humanHardDrive/Arduino_Thermostat/RemoteSensor/Layout/Output/RemoteSensor.pdf

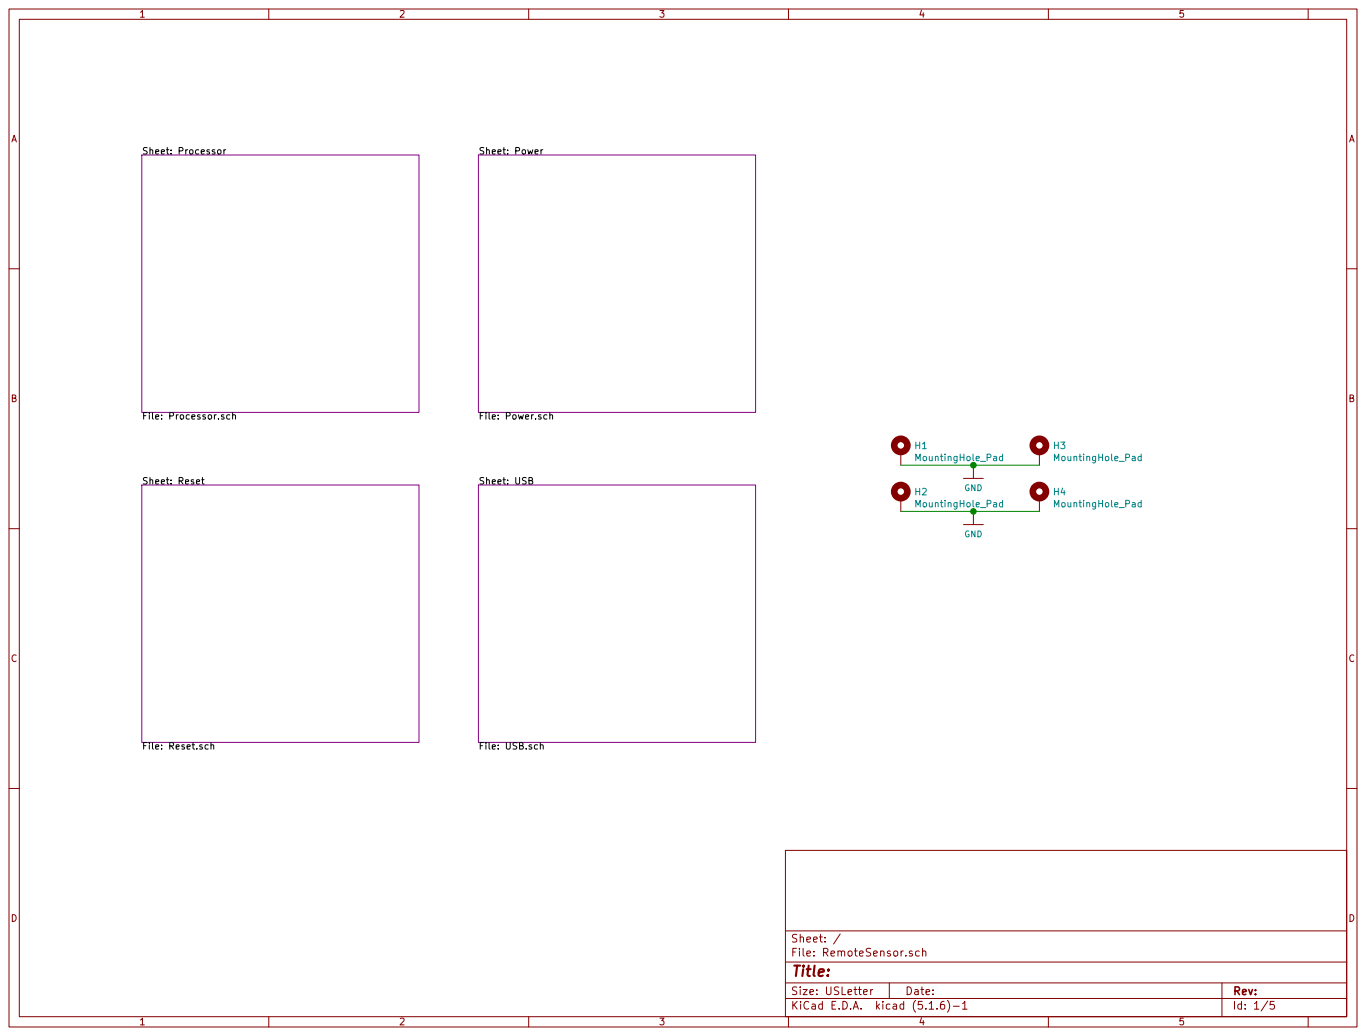
[picture p1: page 1]

Sheet: Power File: Power.sch Sheet: Reset File: Reset.sch

Id: 1/5 Title: File: RemoteSensor.sch Sheet: /

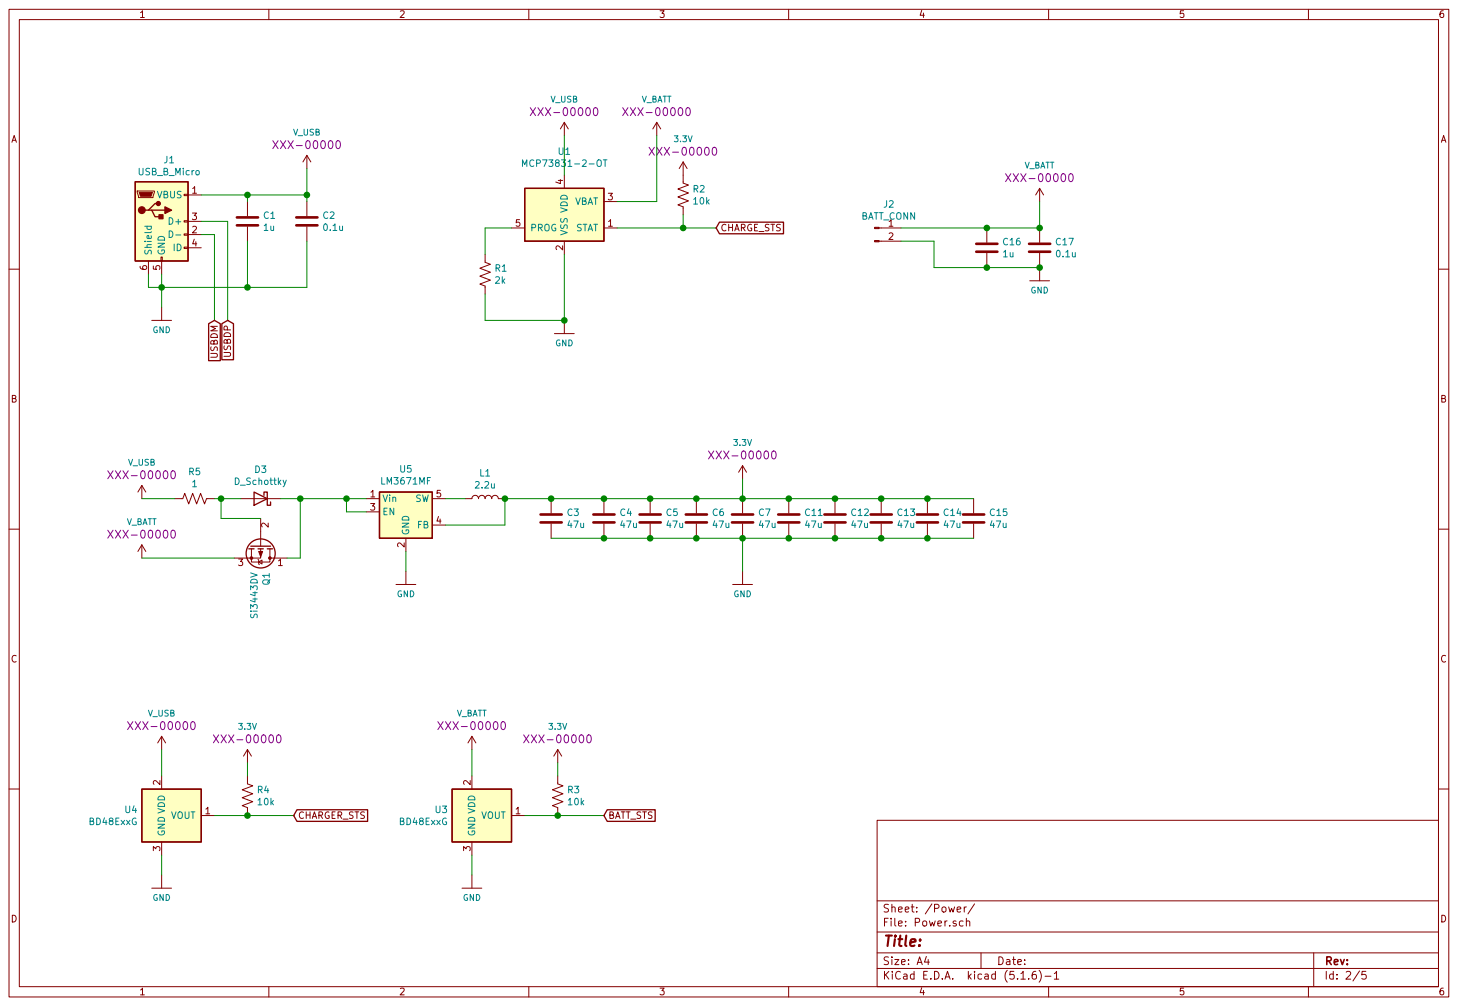
[picture p2: page 2]

Id: 2/5 Title: File: Power.sch Sheet: /Power/ GND

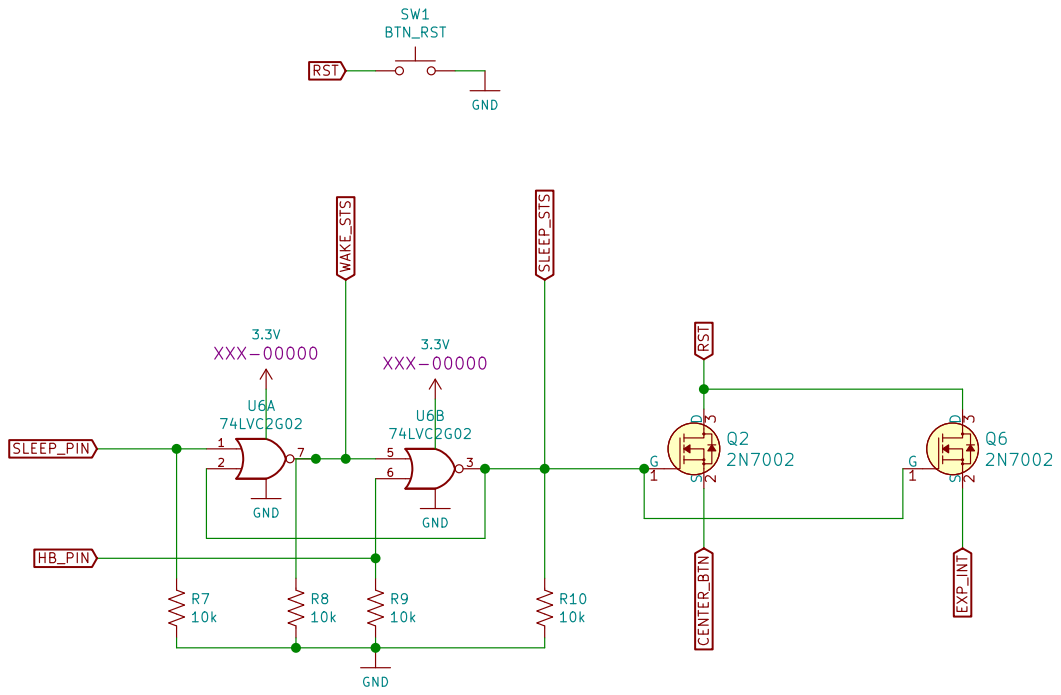
[picture p3: page 3]

Id: 3/5 Title: File: Reset.sch Sheet: /Reset/ R7

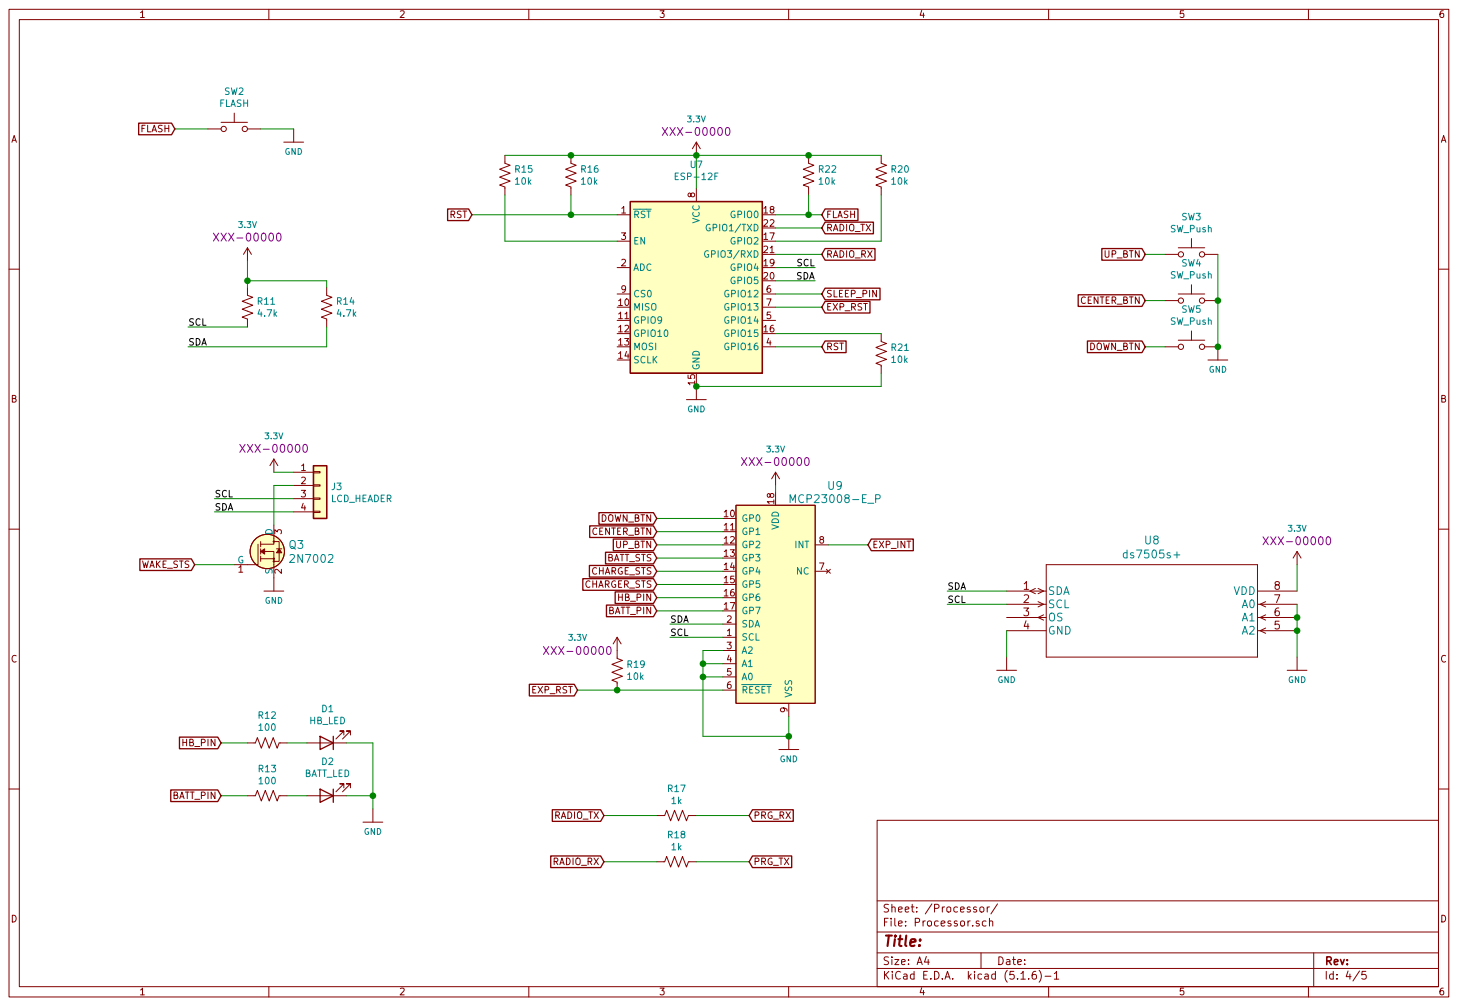
[picture p4: page 4]

Id: 4/5 Title: File: Processor.sch Sheet: /Processor/

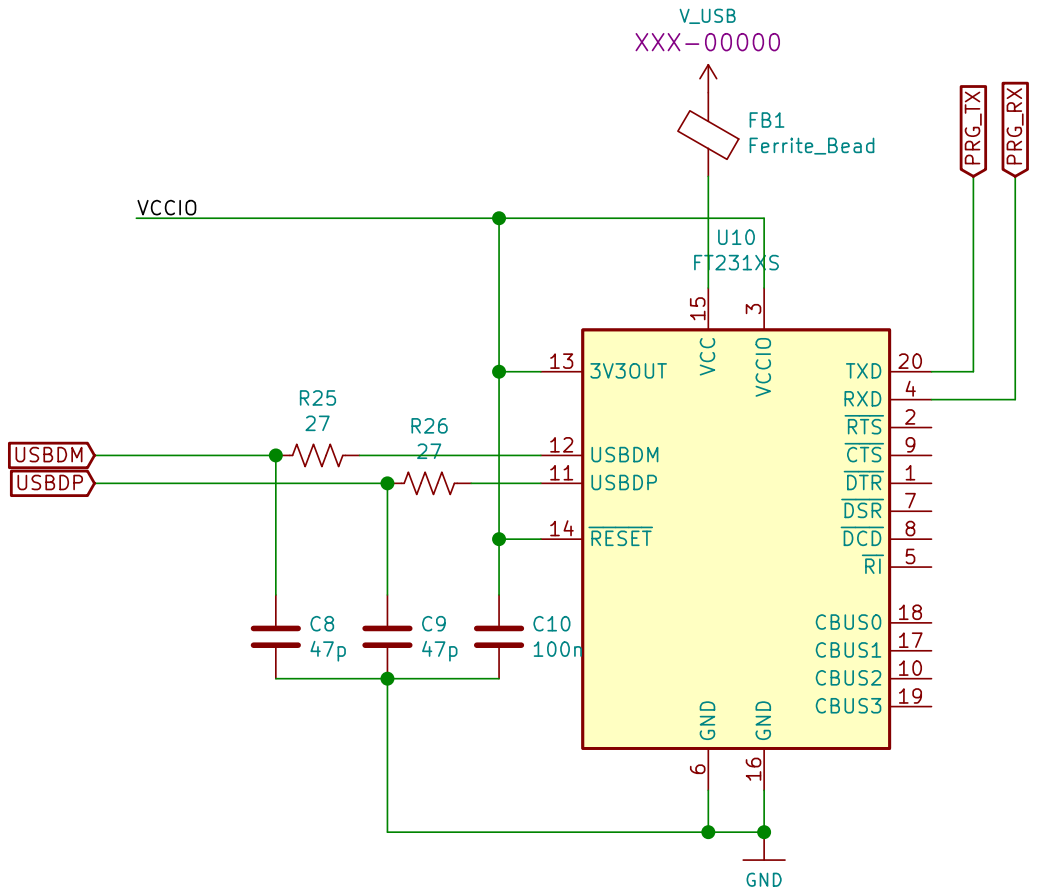
[picture p5: page 5]

Id: 5/5 Title: File: USB.sch Sheet: /USB/
