humanHardDrive/Arduino_Thermostat/(list of files, drawings)

Other design files:
Button_Board/Button_Board.dsn
RemoteSensor/Layout/Output/RemoteSensor.dsn
