humanHardDrive/Arduino_Thermostat/RemoteSensor/Layout/RemoteSensor.kicad_pcb

## KiCad design RemoteSensor/Layout/RemoteSensor.kicad_pcb (2020-09-29)

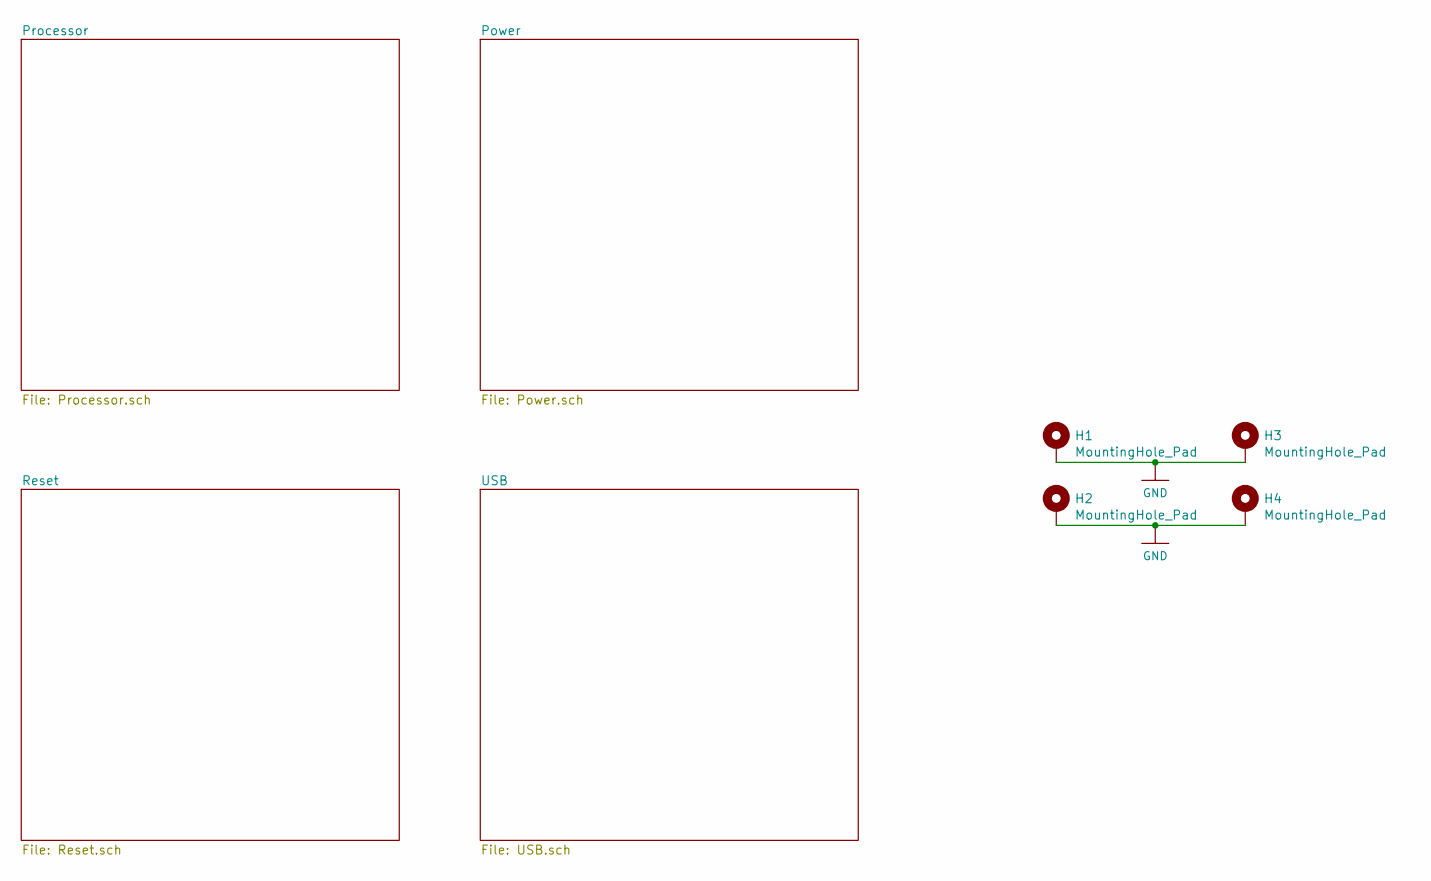
[picture p6: schematic RemoteSensor.sch]

Parts:
H1, H2, H3, H4: MountingHole_Pad; MountingHole_2.7mm_M2.5_DIN965_Pad

Connections:
GND: H1.1, H2.1, H3.1, H4.1; also elsewhere on the board

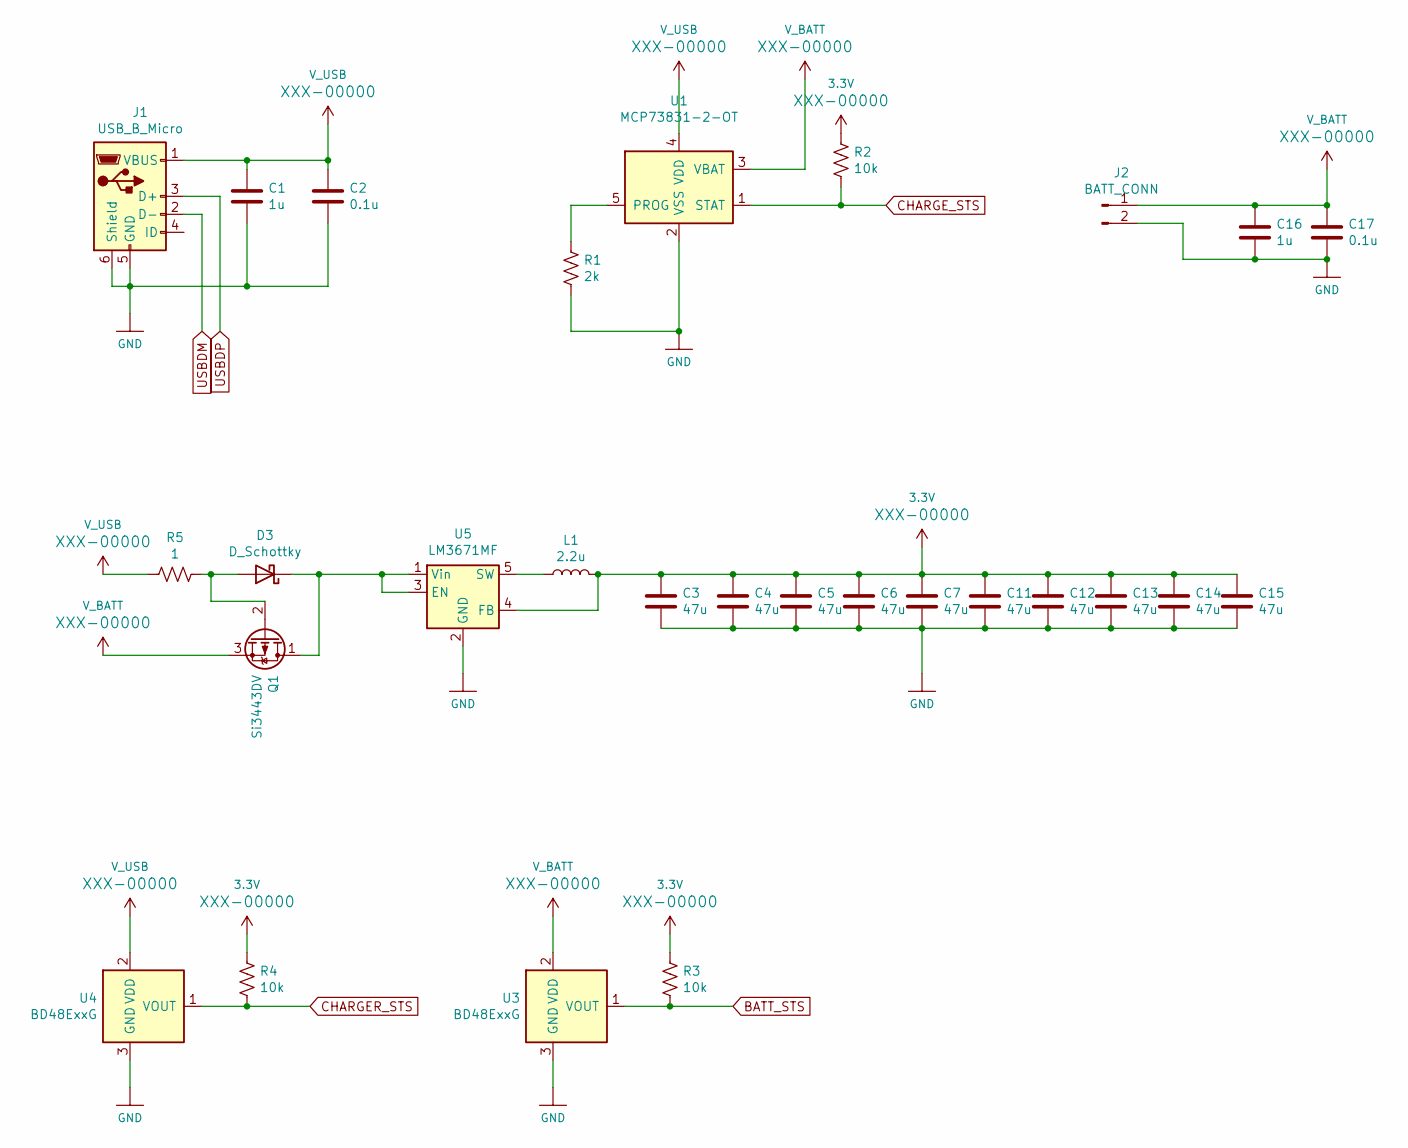
[picture p7: schematic Power.sch]

Parts:
C1, C16: 1u; C_0603_1608Metric_Pad1.05x0.95mm_HandSolder
C2, C17: 0.1u; C_0603_1608Metric_Pad1.05x0.95mm_HandSolder
C3, C4, C5, C6, C7, C11, C12, C13, C14, C15: 47u; C_0603_1608Metric_Pad1.05x0.95mm_HandSolder
D3: D_Schottky; D_SOD-123
J1: USB_B_Micro; USB_Micro-B_Molex_47346-0001
J2: BATT_CONN; JST_PH_S2B-PH-SM4-TB_1x02-1MP_P2.00mm_Horizontal
L1: 2.2u; L_Taiyo-Yuden_NR-30xx_HandSoldering
Q1: Si3443DV
R1: 2k; R_0603_1608Metric_Pad1.05x0.95mm_HandSolder
R2, R3, R4: 10k; R_0603_1608Metric_Pad1.05x0.95mm_HandSolder
R5: 1; R_0603_1608Metric_Pad1.05x0.95mm_HandSolder
U1: MCP73831-2-OT; SOT-23-5
U3, U4: BD48ExxG; SOT-23-5
U5: LM3671MF; TSOT-23-5

Connections:
3.3V: C3.1, C4.1, C5.1, C6.1, C7.1, C11.1, C12.1, C13.1, C14.1, C15.1, L1.2, R2.1, R3.1, R4.1, U5.4 (FB); also elsewhere on the board
BATT_STS: R3.2, U3.1 (VOUT); also elsewhere on the board
CHARGER_STS: R4.2, U4.1 (VOUT); also elsewhere on the board
CHARGE_STS: R2.2, U1.1 (STAT); also elsewhere on the board
GND: C1.2, C2.2, C3.2, C4.2, C5.2, C6.2, C7.2, C11.2, C12.2, C13.2, C14.2, C15.2, C16.2, C17.2, J1.5 (GND), J1.6 (Shield), J2.2, R1.2, U1.2 (VSS), U3.3 (GND), U4.3 (GND), U5.2 (GND); also elsewhere on the board
unnamed: D3.1 (K), Q1.1 (D), U5.1 (Vin), U5.3 (EN)
unnamed: D3.2 (A), Q1.2 (G), R5.1
unnamed: L1.1, U5.5 (SW)
unnamed: R1.1, U1.5 (PROG)
USBDM: J1.2 (D-); also elsewhere on the board
USBDP: J1.3 (D+); also elsewhere on the board
V_BATT: C16.1, C17.1, J2.1, Q1.3 (S), U1.3 (VBAT), U3.2 (VDD)
V_USB: C1.1, C2.1, J1.1 (VBUS), R5.2, U1.4 (VDD), U4.2 (VDD); also elsewhere on the board

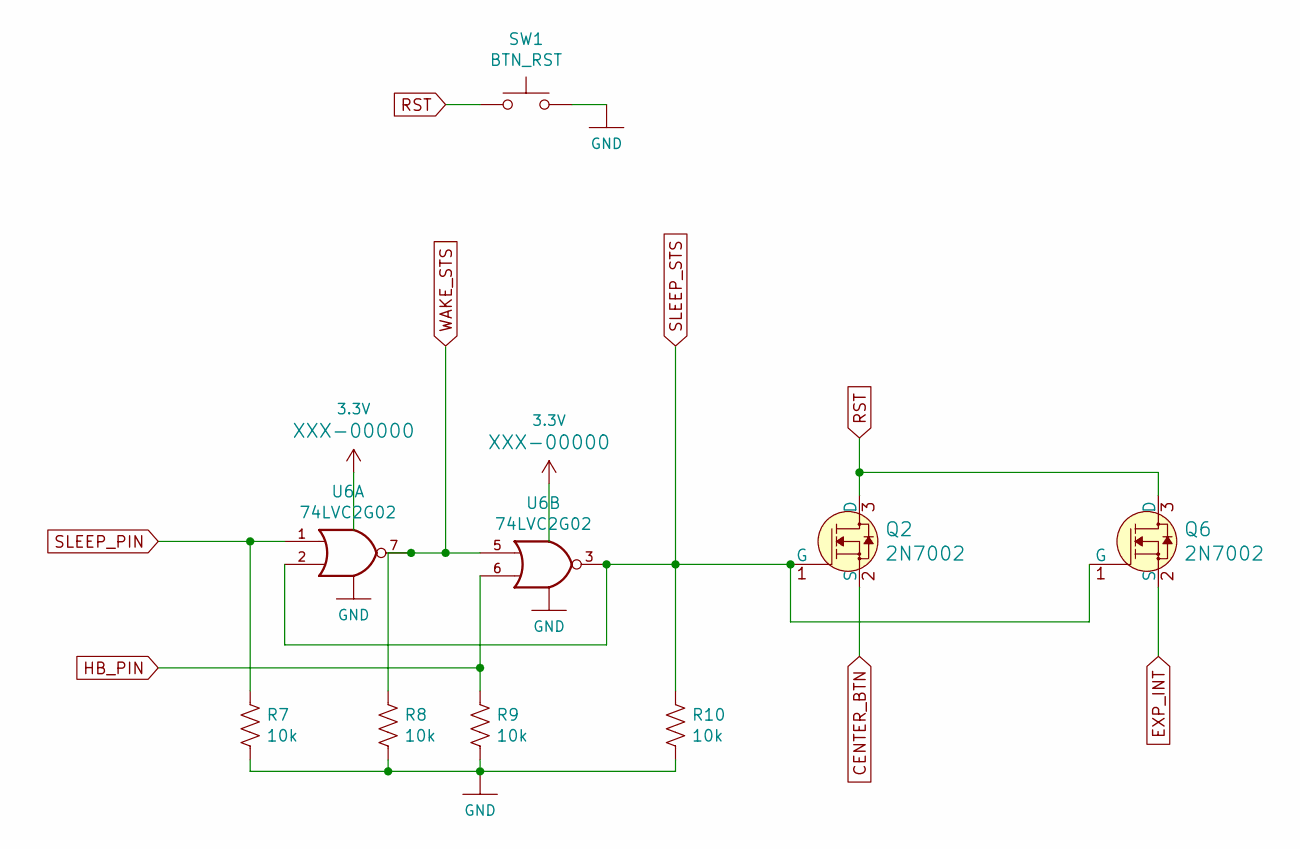
[picture p8: schematic Reset.sch]

Parts:
Q2, Q6: 2N7002; SOT-23-3; MPN 2N7002; Digi-Key_PN 2N7002NCT-ND
R7, R8, R9, R10: 10k; R_0603_1608Metric_Pad1.05x0.95mm_HandSolder
SW1: BTN_RST; SW_SPST_TL3342
U6: 74LVC2G02; VSSOP-8_2.3x2mm_P0.5mm

Connections:
3.3V: U6.8 (VCC); also elsewhere on the board
CENTER_BTN: Q2.2 (S); also elsewhere on the board
EXP_INT: Q6.2 (S); also elsewhere on the board
GND: R7.2, R8.2, R9.2, R10.2, SW1.2, U6.4 (GND); also elsewhere on the board
HB_PIN: R9.1, U6.6; also elsewhere on the board
RST: Q2.3 (D), Q6.3 (D), SW1.1; also elsewhere on the board
SLEEP_PIN: R7.1, U6.1; also elsewhere on the board
SLEEP_STS: Q2.1 (G), Q6.1 (G), R10.1, U6.2, U6.3
WAKE_STS: R8.1, U6.5, U6.7; also elsewhere on the board

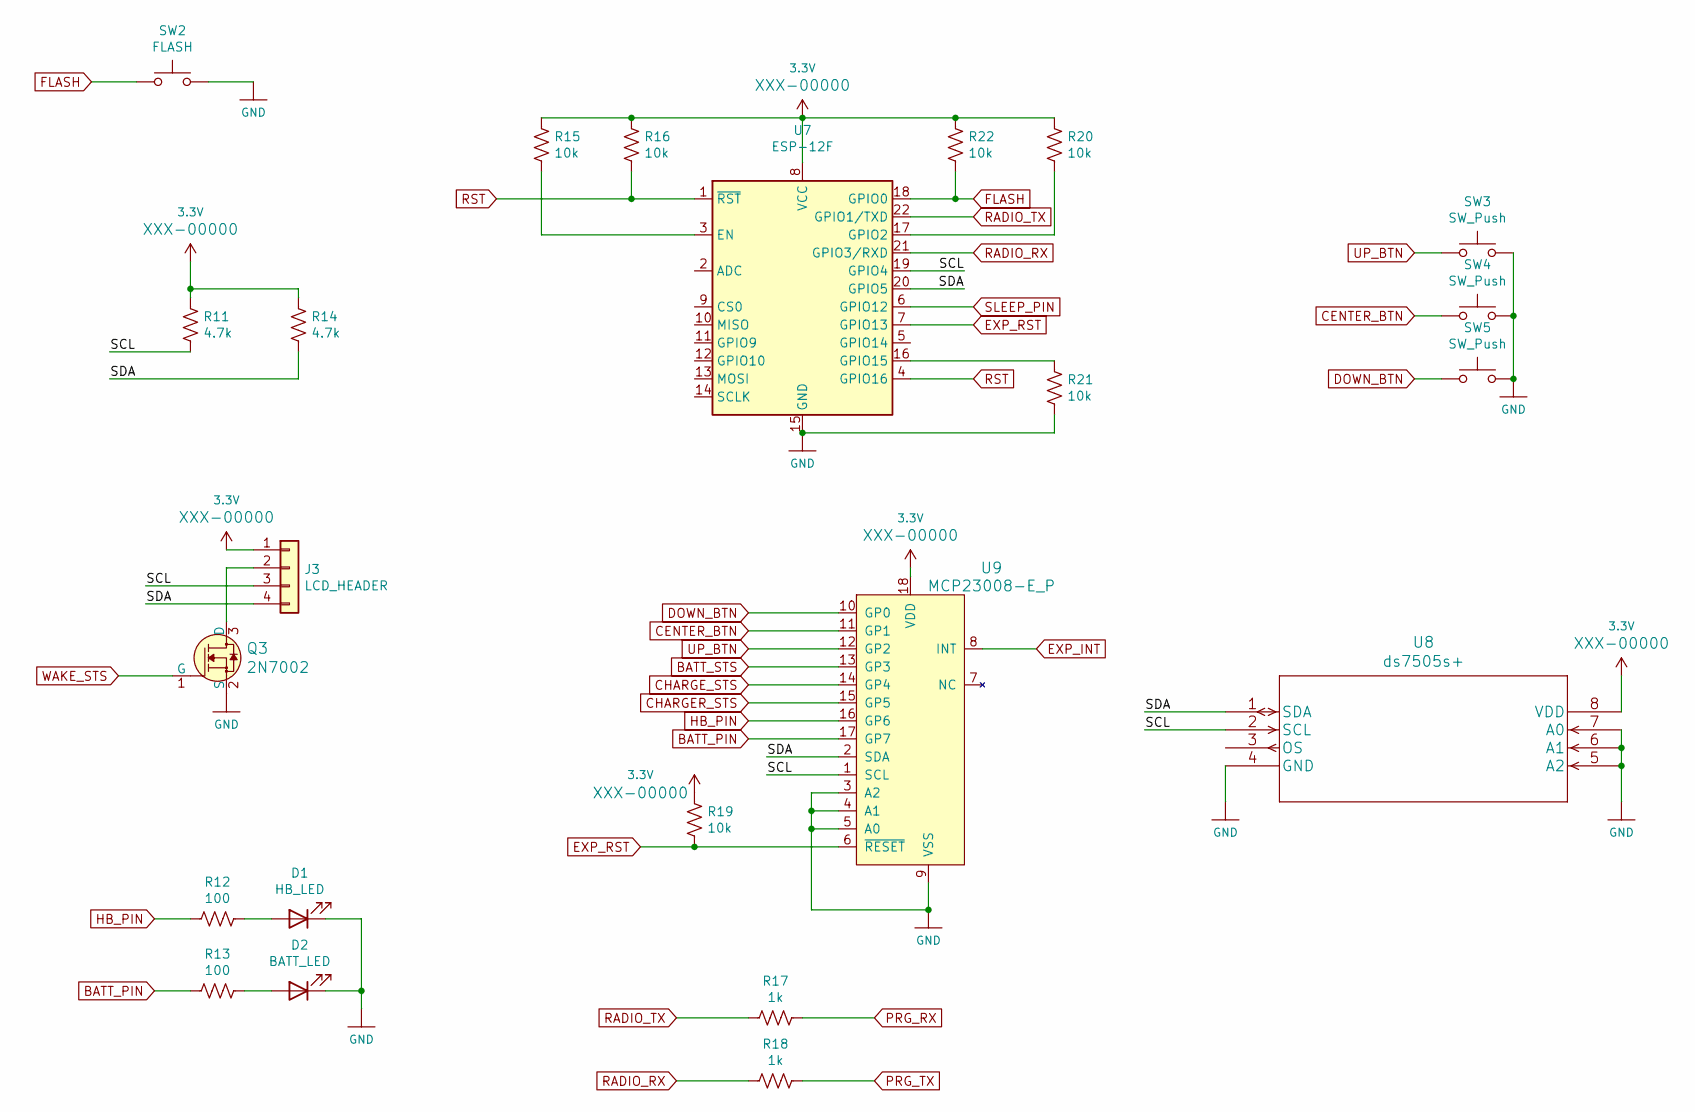
[picture p9: schematic Processor.sch]

Parts:
D1: HB_LED; LED_0603_1608Metric_Pad1.05x0.95mm_HandSolder
D2: BATT_LED; LED_0603_1608Metric_Pad1.05x0.95mm_HandSolder
J3: LCD_HEADER; PinSocket_1x04_P2.54mm_Vertical
Q3: 2N7002; SOT-23-3; MPN 2N7002; Digi-Key_PN 2N7002NCT-ND
R11, R14: 4.7k; R_0603_1608Metric_Pad1.05x0.95mm_HandSolder
R12, R13: 100; R_0603_1608Metric_Pad1.05x0.95mm_HandSolder
R15, R16, R19, R20, R21, R22: 10k; R_0603_1608Metric_Pad1.05x0.95mm_HandSolder
R17, R18: 1k; R_0603_1608Metric_Pad1.05x0.95mm_HandSolder
SW2: FLASH; SW_SPST_TL3342
SW3, SW4, SW5: SW_Push; KSS331GLFS
U7: ESP-12F; ESP-12E
U8: ds7505s+; SOIC-8_3.9x4.9mm_P1.27mm
U9: MCP23008-E_P; SOIC-18W_7.5x11.6mm_P1.27mm; MPN MCP23008-E/P; Digi-Key_PN MCP23008-E/P-ND

Connections:
3.3V: J3.1, R11.1, R14.1, R15.1, R16.1, R19.1, R20.1, R22.1, U7.8 (VCC), U8.8 (VDD), U9.18 (VDD); also elsewhere on the board
/Processor/SCL: J3.3, R11.2, U7.19 (GPIO4), U8.2 (SCL), U9.1 (SCL)
/Processor/SDA: J3.4, R14.2, U7.20 (GPIO5), U8.1 (SDA), U9.2 (SDA)
BATT_PIN: R13.2, U9.17 (GP7)
BATT_STS: U9.13 (GP3); also elsewhere on the board
CENTER_BTN: SW4.1, U9.11 (GP1); also elsewhere on the board
CHARGER_STS: U9.15 (GP5); also elsewhere on the board
CHARGE_STS: U9.14 (GP4); also elsewhere on the board
DOWN_BTN: SW5.1, U9.10 (GP0)
EXP_INT: U9.8 (INT); also elsewhere on the board
EXP_RST: R19.2, U7.7 (GPIO13), U9.6 (~RESET)
FLASH: R22.2, SW2.1, U7.18 (GPIO0)
GND: D1.1 (K), D2.1 (K), Q3.2 (S), R21.2, SW2.2, SW3.2, SW4.2, SW5.2, U7.15 (GND), U8.4 (GND), U8.5 (A2), U8.6 (A1), U8.7 (A0), U9.3 (A2), U9.4 (A1), U9.5 (A0), U9.9 (VSS); also elsewhere on the board
HB_PIN: R12.1, U9.16 (GP6); also elsewhere on the board
unnamed: D1.2 (A), R12.2
unnamed: D2.2 (A), R13.1
unnamed: J3.2, Q3.3 (D)
unnamed: R15.2, U7.3 (EN)
unnamed: R20.2, U7.17 (GPIO2)
unnamed: R21.1, U7.16 (GPIO15)
PRG_RX: R17.1; also elsewhere on the board
PRG_TX: R18.1; also elsewhere on the board
RADIO_RX: R18.2, U7.21 (GPIO3/RXD)
RADIO_TX: R17.2, U7.22 (GPIO1/TXD)
RST: R16.2, U7.1 (~RST), U7.4 (GPIO16); also elsewhere on the board
SLEEP_PIN: U7.6 (GPIO12); also elsewhere on the board
UP_BTN: SW3.1, U9.12 (GP2)
WAKE_STS: Q3.1 (G); also elsewhere on the board

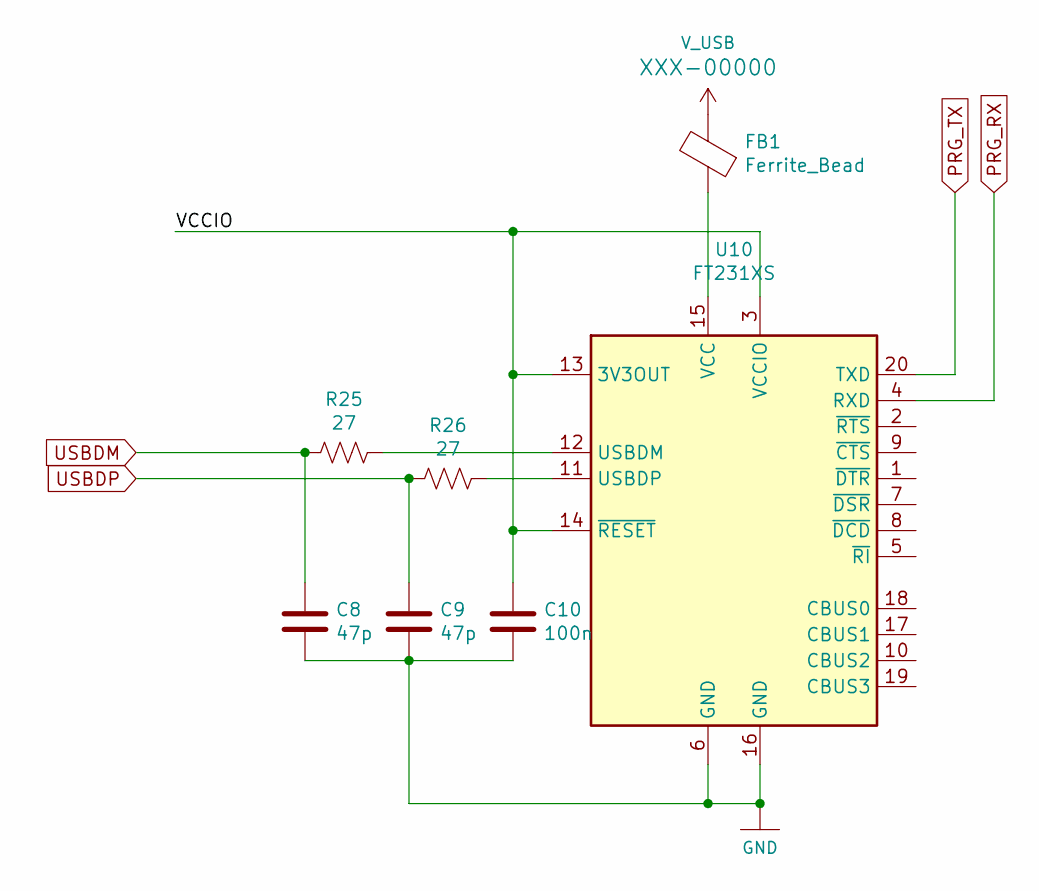
[picture p10: schematic USB.sch]

Parts:
C8, C9: 47p; C_0603_1608Metric_Pad1.05x0.95mm_HandSolder
C10: 100n; C_0603_1608Metric_Pad1.05x0.95mm_HandSolder
FB1: Ferrite_Bead; R_0603_1608Metric_Pad1.05x0.95mm_HandSolder
R25, R26: 27; R_0603_1608Metric_Pad1.05x0.95mm_HandSolder
U10: FT231XS; SSOP-20_3.9x8.7mm_P0.635mm

Connections:
/USB/VCCIO: C10.1, U10.3 (VCCIO), U10.13 (3V3OUT), U10.14 (~RESET)
GND: C8.2, C9.2, C10.2, U10.6 (GND), U10.16 (GND); also elsewhere on the board
unnamed: FB1.1, U10.15 (VCC)
unnamed: R25.1, U10.12 (USBDM)
unnamed: R26.1, U10.11 (USBDP)
PRG_RX: U10.4 (RXD); also elsewhere on the board
PRG_TX: U10.20 (TXD); also elsewhere on the board
USBDM: C8.1, R25.2; also elsewhere on the board
USBDP: C9.1, R26.2; also elsewhere on the board
V_USB: FB1.2; also elsewhere on the board

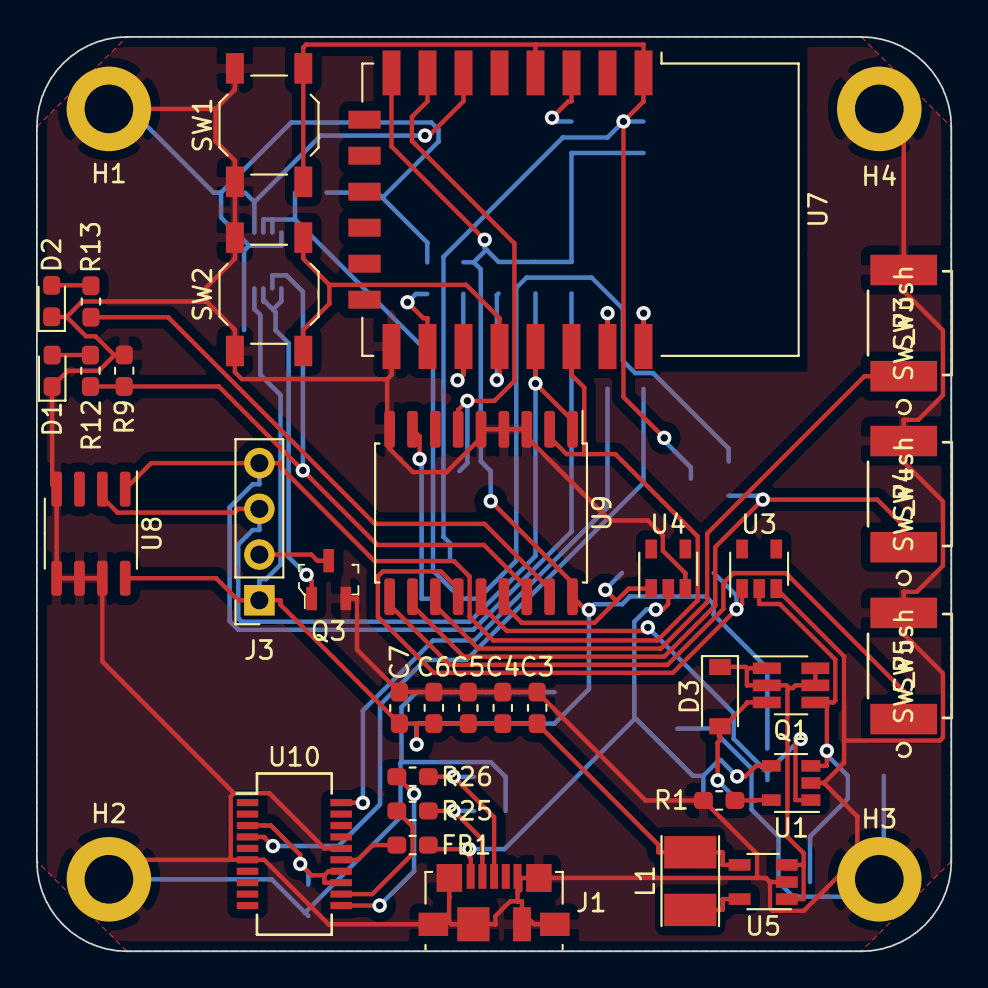
[picture p11: board RemoteSensor.kicad_pcb from above]

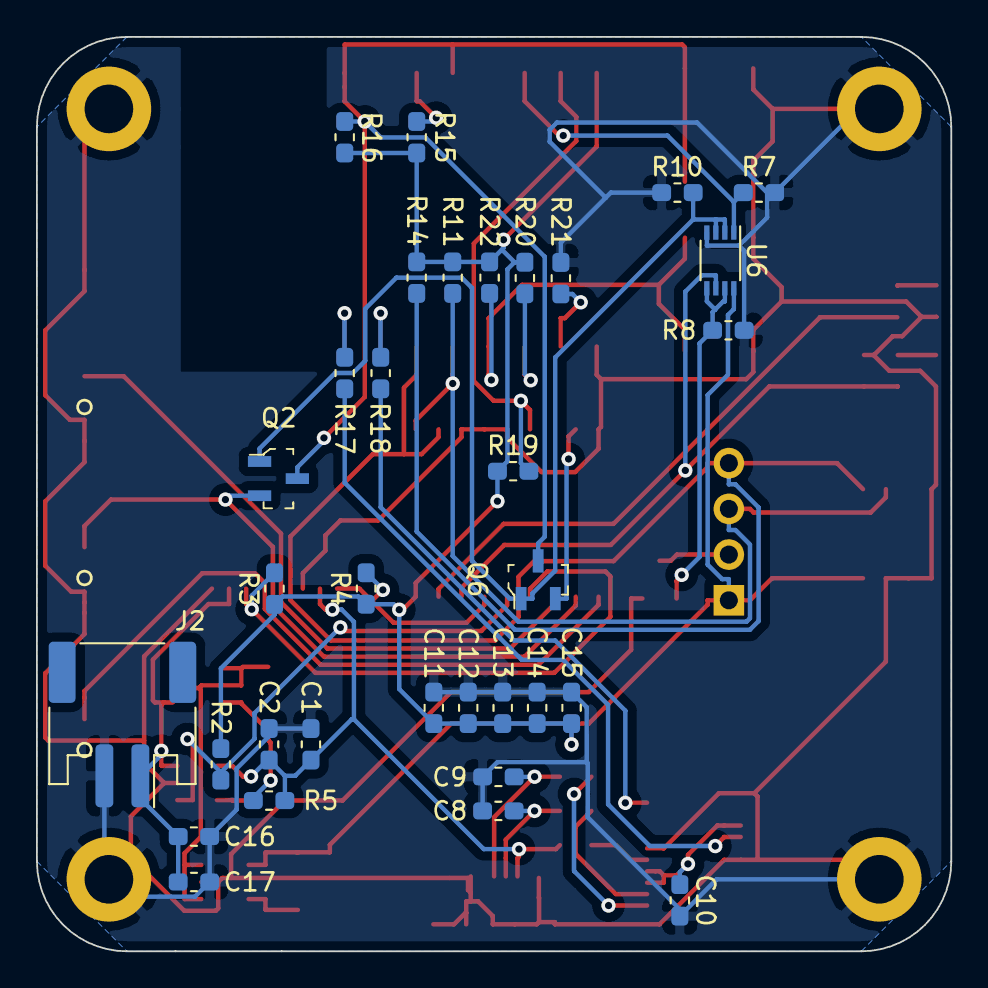
[picture p12: board RemoteSensor.kicad_pcb from below]

Board: 2 copper layers, 50.8 x 50.8 mm, 70 parts (33 on the bottom side), 41 nets.
