humanHardDrive/Arduino_Thermostat/Button_Board/Button_Board.kicad_pcb

## KiCad design Button_Board/Button_Board.kicad_pcb (2019-10-31)

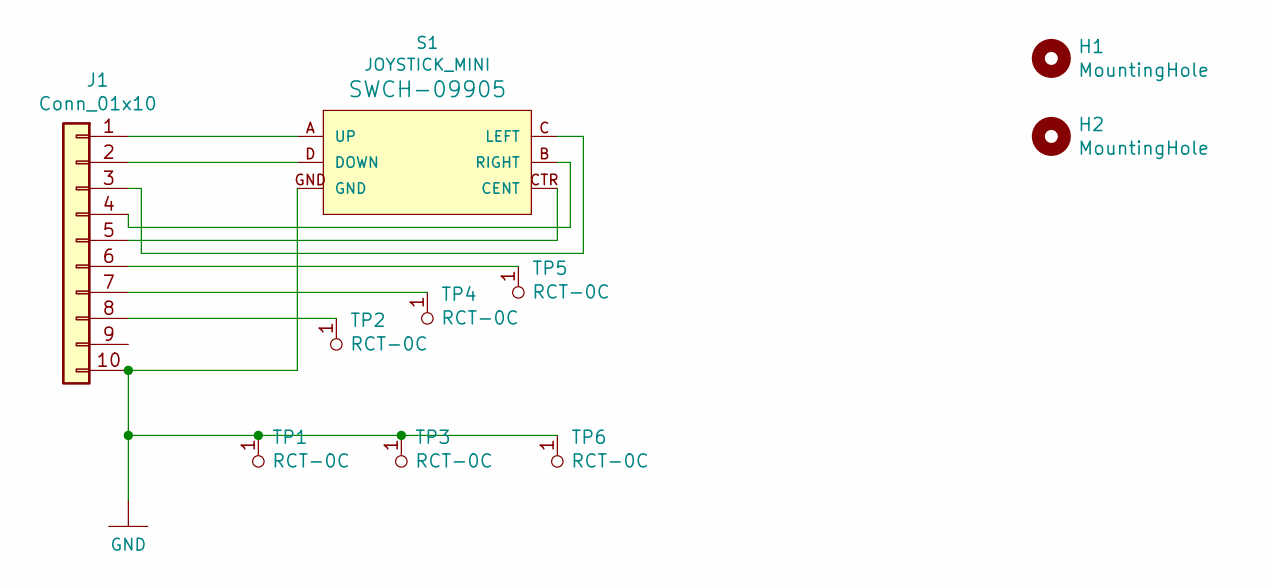
[picture p13: schematic Button_Board.sch]

Parts:
H1, H2: MountingHole; MountingHole_2.2mm_M2_ISO7380_Pad
J1: Conn_01x10; JST_PH_B10B-PH-SM4-TB_1x10-1MP_P2.00mm_Vertical
S1: JOYSTICK_MINI
TP1, TP2, TP3, TP4, TP5, TP6: RCT-0C; PROBE_PAD_0805; MPN RCT-0C; Digi-Key_PN A106144CT-ND

Connections:
GND: J1.10, S1.GND, TP1.1, TP3.1, TP6.1
unnamed: J1.1, S1.A (UP)
unnamed: J1.2, S1.D (DOWN)
unnamed: J1.3, S1.C (LEFT)
unnamed: J1.4, S1.B (RIGHT)
unnamed: J1.5, S1.CTR (CENT)
unnamed: J1.6, TP5.1
unnamed: J1.7, TP4.1
unnamed: J1.8, TP2.1

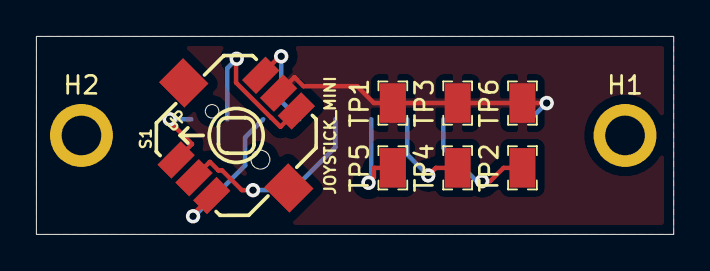
[picture p14: board Button_Board.kicad_pcb from above]

Board: 2 copper layers, 35.4 x 11.0 mm, 10 parts (1 on the bottom side), 9 nets.
