humanHardDrive/Arduino_Thermostat/Thermostat/Thermostat.ino

#include <Wire.h>
#include <DS3231.h>
#include <LiquidCrystal.h>
#include <Sleep_n0m1.h>
#include <Streaming.h>

#include "ThermostatDevice.h"
#include "SensorDevice.h"
#include "ESPInterface.h"

#define APP_NAME    F("REMOTE THERMOSTAT")
#define VERSION_MAJOR   0
#define VERSION_MINOR   0

/*Basic logging macro*/
#define LOG Serial << "\n\r" << millis() << '\t' << __FUNCTION__ << '\t'

//Arduino Pins
#define IO_EXP_RST_PIN  13
#define ESP_RST_PIN     12
#define ESP_EN_PIN      11
#define ESP_ST_PIN      10
#define LCD_RS_PIN      9
#define LCD_EN_PIN      8
#define LCD_D4_PIN      7
#define LCD_D5_PIN      6
#define LCD_D6_PIN      5
#define LCD_D7_PIN      4
#define HEARTBEAT_PIN   3
#define IO_EXP_INT_PIN  2

#define BATT_MON_EN_PIN A0
#define DBG_TX_PIN      A1
#define DBG_RX_PIN      A2
#define I2C_SDA         A4
#define I2C_SCL         A5
#define LOCAL_TEMP_PIN  A6
#define BATT_MON_PIN    A7

struct SaveInfo
{
  APInfo apInfo;
  ServerInfo serverInfo;

  uint16_t checksum;
};

SaveInfo saveInfo;

ESPInterface      espInterface;
SensorDevice      sensorDevice(LOCAL_TEMP_PIN, 1000, 1000);
ThermostatDevice  thermostatDevice(espInterface);

DS3231 Clock;
RTClib RTC;

bool bNeedRealTime = true;
uint32_t nLastTimePoll = 0;

char* sPubAliasList[] =
{
  "CurrentTemp",
  "CurrentMode",
  "" /*The empty string is the end of the array*/
};

char* sSubAliasList[] =
{
  "TargetTemp",
  "TargetMode",
  ""
};

bool waitForESPResponse(uint8_t cmd, void* outBuf, uint8_t outLen, void** inBuf, uint32_t timeout)
{
  bool bMsgReady = false;
  uint32_t nStartTime;
  uint8_t inCmd;

  espInterface.sendCommand(cmd, outBuf, outLen);
  delay(1);
  nStartTime = millis();

  while ((millis() - nStartTime) < timeout && !bMsgReady)
  {
    if (Serial.available())
    {
      espInterface.background(Serial.read());
      bMsgReady = espInterface.messageReady(&inCmd, inBuf);

      /*Continue processing messages while waiting for the response*/
      if (bMsgReady)
      {
        if (inCmd != cmd)
        {
          LOG << F("Unexpected response for cmd type ") << inCmd;
          bMsgReady = false;
        }
        /*Reset timer*/
        nStartTime = millis();
      }
    }
  }

  if (!bMsgReady)
  {
    LOG << F("No message returned");
    return false;
  }

  return true;
}

bool InitESPInterface()
{
  uint8_t *buf;

  LOG << F("Resetting ESP interface");
  digitalWrite(ESP_RST_PIN, LOW);
  delay(1);
  digitalWrite(ESP_RST_PIN, HIGH);

  /*Wait at most 10 seconds for the interface to show ready status*/
  uint32_t nStatusStartTime = millis();
  while ((millis() - nStatusStartTime) < 10000 &&
         digitalRead(ESP_ST_PIN))
  {
  }

  if (digitalRead(ESP_ST_PIN))
  {
    LOG << F("Interface didn't show ready status in time");
    return false;
  }

  return true;
}

void RecoverInfo()
{
  memset(&saveInfo, 0, sizeof(SaveInfo));

  thermostatDevice.setOffset(sizeof(SaveInfo));
  thermostatDevice.recover();
}

bool InitIOExpander()
{
  return false;
}

bool InitRTC()
{
  DateTime then = RTC.now();
  delay(1500);

  if (RTC.now().unixtime() == then.unixtime())
  {
    LOG << F("Failed to see clock change");
    return false;
  }

  LOG << F("Date ") << then.day() << '/' << then.month() << '/' << then.year();
  LOG << F("Time ") << then.hour() << ':' << then.minute();

  return true;
}

void setup()
{
  /*Setup serial*/
  Serial.begin(57600);
  Wire.begin();

  /*Setup pin directions*/
  pinMode(ESP_RST_PIN, OUTPUT);
  pinMode(ESP_ST_PIN, INPUT_PULLUP);

  /*Initialize components*/
  if (!InitESPInterface())
  {
    LOG << F("Failed to init ESP interface");
    while (1);
  }

  if (!InitRTC())
  {
    LOG << F("Failed to init RTC");
    while (1);
  }
}

void loop()
{
  if (bNeedRealTime && (millis() - nLastTimePoll) > 30000)
  {
    uint32_t* pCurrentTime;
    if (waitForESPResponse(TIME, NULL, 0, &pCurrentTime, 10))
    {
      if (*pCurrentTime)
      {
        LOG << F("Got current time");
        bNeedRealTime = false;
      }
      else
        LOG << F("ESP isn't connected to internet. Can't get time");
    }

    nLastTimePoll = millis();
    if (bNeedRealTime)
      LOG << F("Couldn't get time from ESP interface");
  }
}
