humanHardDrive/Arduino_Thermostat/Thermostat/ThermostatDevice.cpp

#include "ThermostatDevice.h"

ThermostatDevice::ThermostatDevice(MemDevice& memDevice) :
  m_MemDevice(memDevice)
{
  
}

void ThermostatDevice::update(DAY_OF_WEEK day, uint8_t nHour, uint8_t nMinute)
{
  
}
