humanHardDrive/Arduino_Thermostat/(commit log)

2019-04-10 Add temperature sensor project. Other changes.
2019-04-13 Put interface buttons on the IO expander
2019-04-14 Add modes for fan control and heat
2019-04-18 Add RTC library
    Use the RTC to set the target temperature based on a timed rule set.
2019-04-29 Start setting up the remote temperature sensor.
2019-04-30 Setup more of the thermostat's communication
    Handle entering and exiting discovery mode. Added some debug serial commands to interface without buttons.
2019-05-07 First successful recieve and trasmit
    Need to get the discovery pipe working properly and parse the message on the sensor side.
2019-05-11 Remove old code. Verify new functionality.
    The discovery message now only acts as a discovery, not discovery and pair. The remote device returns a name to be identified.
2019-05-11 Handle device discovery.
    List out all of the discovered devices
2019-05-19 Setup messages on the sensor to send temperature reading
2019-05-19 Start setting up handlers for temperature messages
    Started adding hooks to retry messages.
2019-05-19 Handle messages on the temperature sensor
2019-05-21 Add method to add paired device to saved list
2019-05-22 Add paired device to saved data list
2019-05-22 Only handle messages from paired devices
2019-05-23 Add function to rename paired devices
2019-05-24 Initialize temperature rules structure before overwritten by flash
2019-05-25 Add button debounce to IO expander
2019-05-25 Print day and time on LCD
2019-05-25 Create local temperature sensor for the base station
    Use a thermistor and do math
2019-05-26 Setup hysteresis for switching heat/cool on and off
2019-05-27 Switch to a different memory chip
2019-05-28 Use memory device to finish save/load functions
2019-05-31 Recover settings from NV memory
    Move the calls to reset and restore to the child class
    [Thermostat.ino]
2019-05-31 Share memory library with temperature sensor
2019-05-31 Update sensor with recover/reset/save functions
2019-06-01 Start laying out the thermostat schematic
    [schematic.sch]
2019-06-01 Reorder pins to get IO expander interrupt
2019-06-01 Sleep and wake to save battery
2019-06-03 Scroll through paired devices on menu
2019-06-03 Store remote temperatures in array
2019-06-03 Add message for remote to request being used as sensor
2019-06-03 Handle new message request on base station
    Clean up debug print statments.
2019-06-05 Sleep the sensor to perserve power
2019-06-05 Add LED control to display sensor state
2019-06-06 Take periodic temperature readings. Rename a few things
2019-06-06 Softly blink LED while pairing
2019-06-07 Update temperature reading on the base station
2019-06-09 Reorder some menu elements. Add the sensor menu element
2019-06-09 Can't test discovery without the radio attached
2019-06-27 Update schematic
2019-06-27 More schematic updates
    [schematic.sch]
2019-06-28 More layout changes
    [schematic.sch]
2019-07-05 Add a second IO expander to handle LCD
    [schematic.brd, schematic.dxf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]
2019-07-21 Clean up schematic and board
    [schematic.brd, schematic.dxf, schematic.sch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]
2019-08-07 Switch to KiCad for layout. Finished the thermostat layout.
    [IOExpander.sch, LCD.sch, Power.sch, ProcessorConnections.sch, RTC.sch, Radio.sch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]
2019-08-08 Update remote sensor layout
    [Power.sch, ProcessorConnections.sch, Radio.sch]
2019-08-10 Update processor pin definitions
    [Power.sch, ProcessorConnections.sch]
2019-08-11 Add new messages for the remote sensor
2019-08-11 Fix analog temperature reading. Add button schematic.
    [Button_Board.kicad_pcb, Button_Board.sch]
2019-08-12 Update button board PCB
    [Button_Board.dsn, Button_Board.kicad_pcb, Button_Board.sch]
2019-10-05 Remove NRF24 from schematic
    [Radio.sch, Thermostat_Layout.kicad_pcb]
2019-10-05 Remove nrf24 code from sensor
2019-10-10 Layout changes
    [ProcessorConnections.sch, Radio.sch]
2019-10-10 Complete radio schematic
    [Radio.sch]
2019-10-10 Swap out the MCP23s17 for the MCP23017
    Removes the need for the SPI bus
    [IOExpander.sch, ProcessorConnections.sch]
2019-10-11 FInalize schematic for thermostat
    [IOExpander.sch, LCD.sch, Power.sch, ProcessorConnections.sch, RTC.sch, Radio.sch, Thermostat_Layout.kicad_pcb]
2019-10-13 Make commands case insensitive
2019-10-31 Schematic and PCB layout for thermostat
    [IOExpander.sch, LCD.sch, Power.sch, ProcessorConnections.sch, Radio.sch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]
2019-10-31 Button board layout with mini joystick
    [Button_Board.dsn, Button_Board.kicad_pcb, Button_Board.sch, Thermostat_Layout.kicad_pcb]
2019-10-31 Add output
    [Button_Board-B_Cu.gbr, Button_Board-B_Mask.gbr, Button_Board-B_Paste.gbr, Button_Board-B_SilkS.gbr, Button_Board-Edge_Cuts.gbr, Button_Board-F_Cu.gbr, Button_Board-F_Mask.gbr, Button_Board-F_Paste.gbr]
2019-10-31 Button PCB update
    [Button_Board.kicad_pcb]
2019-11-03 Folder rename
    [Power.sch, ProcessorConnections.sch, Radio.sch, Thermostat_Remote.kicad_pcb, Thermostat_Remote.sch]
2019-11-24 Cleanup
    Need to re-write the IO expander to support I2C
2019-12-04 Move some components around
    [LCD.sch, Thermostat_Layout.kicad_pcb]
2019-12-15 Message ready function returns current message buffer
2019-12-15 Update pin definitions
2019-12-22 Limit error messages for initialized ESP interface
    [Thermostat.ino]
2020-04-19 Create thermostat device
2020-04-19 Setup thermostat device
2020-04-20 Flesh out more of the thermostat device
2020-04-22 Setup remote sensor class
2020-04-22 Setup temperature sampling
2020-05-17 Update sensor
2020-05-18 Reorganize folders. New remote layout.
    [IOExpander.sch, LCD.sch, Power.sch, ProcessorConnections.sch, RTC.sch, Radio.sch, RemoteSensor.kicad_pcb, RemoteSensor.sch]
2020-05-21 Add lipo support
    [RemoteSensor.sch]
2020-05-21 Finish schematic
    [RemoteSensor.sch]
2020-05-23 More power control. Add some mounting holes.
    [RemoteSensor.sch]
2020-05-23 Generate PCB
    [RemoteSensor.kicad_pcb]
2020-05-23 Finalize PCB
    [RemoteSensor.kicad_pcb, RemoteSensor.sch]
2020-05-24 Copper pour
    [RemoteSensor.kicad_pcb]
2020-05-24 Fix resistor on wrong side
    [RemoteSensor.dsn, RemoteSensor.kicad_pcb]
2020-05-24 Add schematic PDF
2020-05-24 Update LED status
2020-05-24 Monitor button state changes
    Refresh the wake time every time a button is hit.
2020-05-24 Cleanup thermostat layout
    [IOExpander.sch, LCD.sch, Power.sch, ProcessorConnections.sch, RTC.sch, Radio.sch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]
2020-05-27 New schematics
    [Thermostat.kicad_pcb, Thermostat.sch, io.sch, power.sch, processor.sch]
2020-05-30 Add method to build device name
2020-06-12 Change some component values
    [RemoteSensor.sch]
2020-06-12 Fix charger and battery status
    [RemoteSensor.kicad_pcb, RemoteSensor.sch]
2020-06-13 Remove power control for temperature sensor
    [RemoteSensor.sch]
2020-06-16 Add second regulator for USB
    [RemoteSensor.sch]
2020-06-17 Move circuits on different sheets
    [Power.sch, Processor.sch, RemoteSensor.sch, Reset.sch]
2020-06-17 Update schematic sheet
2020-06-21 Add an IO expander
    [Power.sch, Processor.sch]
2020-06-21 Assign footprints
    [Power.sch, Processor.sch]
2020-06-25 Add FTDI USB to serial
    [Power.sch, Processor.sch, RemoteSensor.sch, Reset.sch, USB.sch]
2020-06-25 Update sensor schematic
    [Power.sch, Processor.sch, RemoteSensor.sch, Reset.sch, USB.sch]
2020-06-27 Add footprints and component values
    [Power.sch, Processor.sch, USB.sch]
2020-06-28 Edit layout
    [Processor.sch, RemoteSensor.kicad_pcb, Reset.sch]
2020-07-01 New PCB layout
    [RemoteSensor.kicad_pcb]
2020-07-01 Update schematic PDF
2020-07-04 Change pin definitions
2020-08-08 Change the USB switching regulator for an LDO
    [Power.sch, Processor.sch, RemoteSensor.dsn, RemoteSensor.kicad_pcb]
2020-08-09 Update PCB layout
    [Processor.sch, RemoteSensor.kicad_pcb, USB.sch]
2020-08-09 Generate routing
    [RemoteSensor.dsn, RemoteSensor.kicad_pcb]
2020-08-10 Update outputs
    [Processor.sch, RemoteSensor.kicad_pcb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]
2020-08-13 Remove pour from keep out zone under antenna
    [RemoteSensor.kicad_pcb]
2020-08-29 Switch to X macros
    Debug the board. Issues with the sleep latch
    [RemoteSensor.ino]
2020-09-07 Change what pins are used for i2c
    [Power.sch, Processor.sch, RemoteSensor.sch, Reset.sch, USB.sch]
2020-09-07 Diode protect usb voltage
    [Power.sch]
2020-09-19 Change how power is switched between battery and USB
    [Power.sch, Processor.sch, RemoteSensor.kicad_pcb, USB.sch]
2020-09-20 Change out nav switch for tactile
    [Processor.sch]
2020-09-26 Another layout
    [Power.sch, Processor.sch, RemoteSensor.dsn, RemoteSensor.kicad_pcb, Reset.sch, USB.sch]
